ealex/stm32f334_1S_charger/hardware/stm32f334_1S_charger/stm32f334_1S_charger.pdf

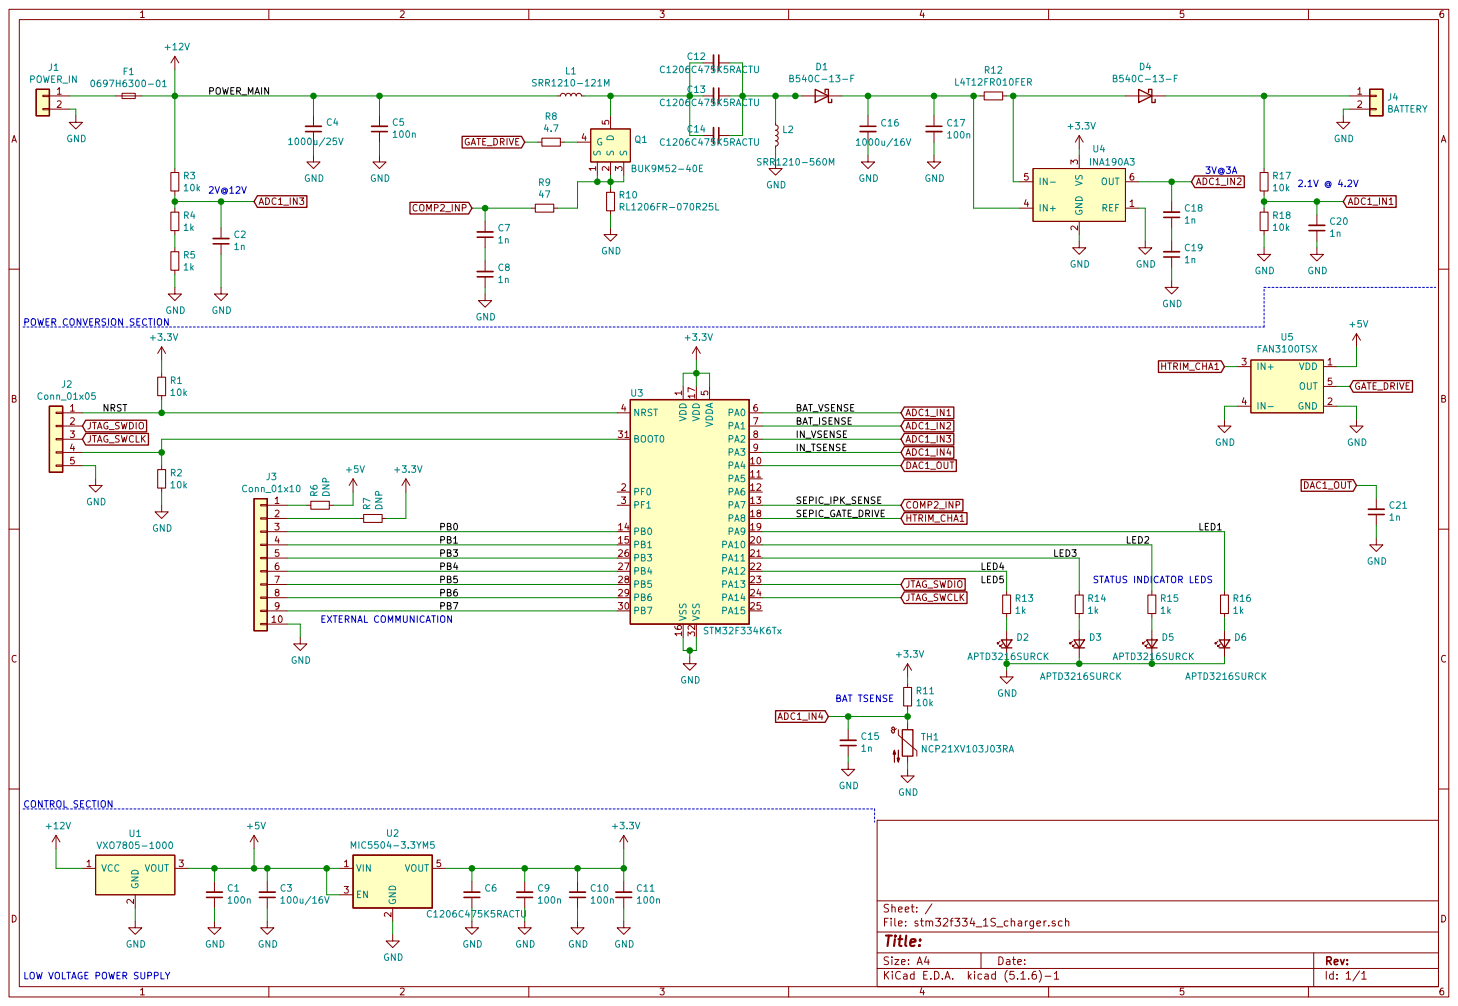
[picture p1: page 1]

4 | LED2
5 | LED3

LOW VOLTAGE POWER SUPPLY CONTROL SECTION
