ealex/stm32f334_1S_charger/hardware/stm32f334_1S_charger/stm32f334_1S_charger.kicad_pcb

## KiCad design hardware/stm32f334_1S_charger/stm32f334_1S_charger.kicad_pcb (2020-06-14)

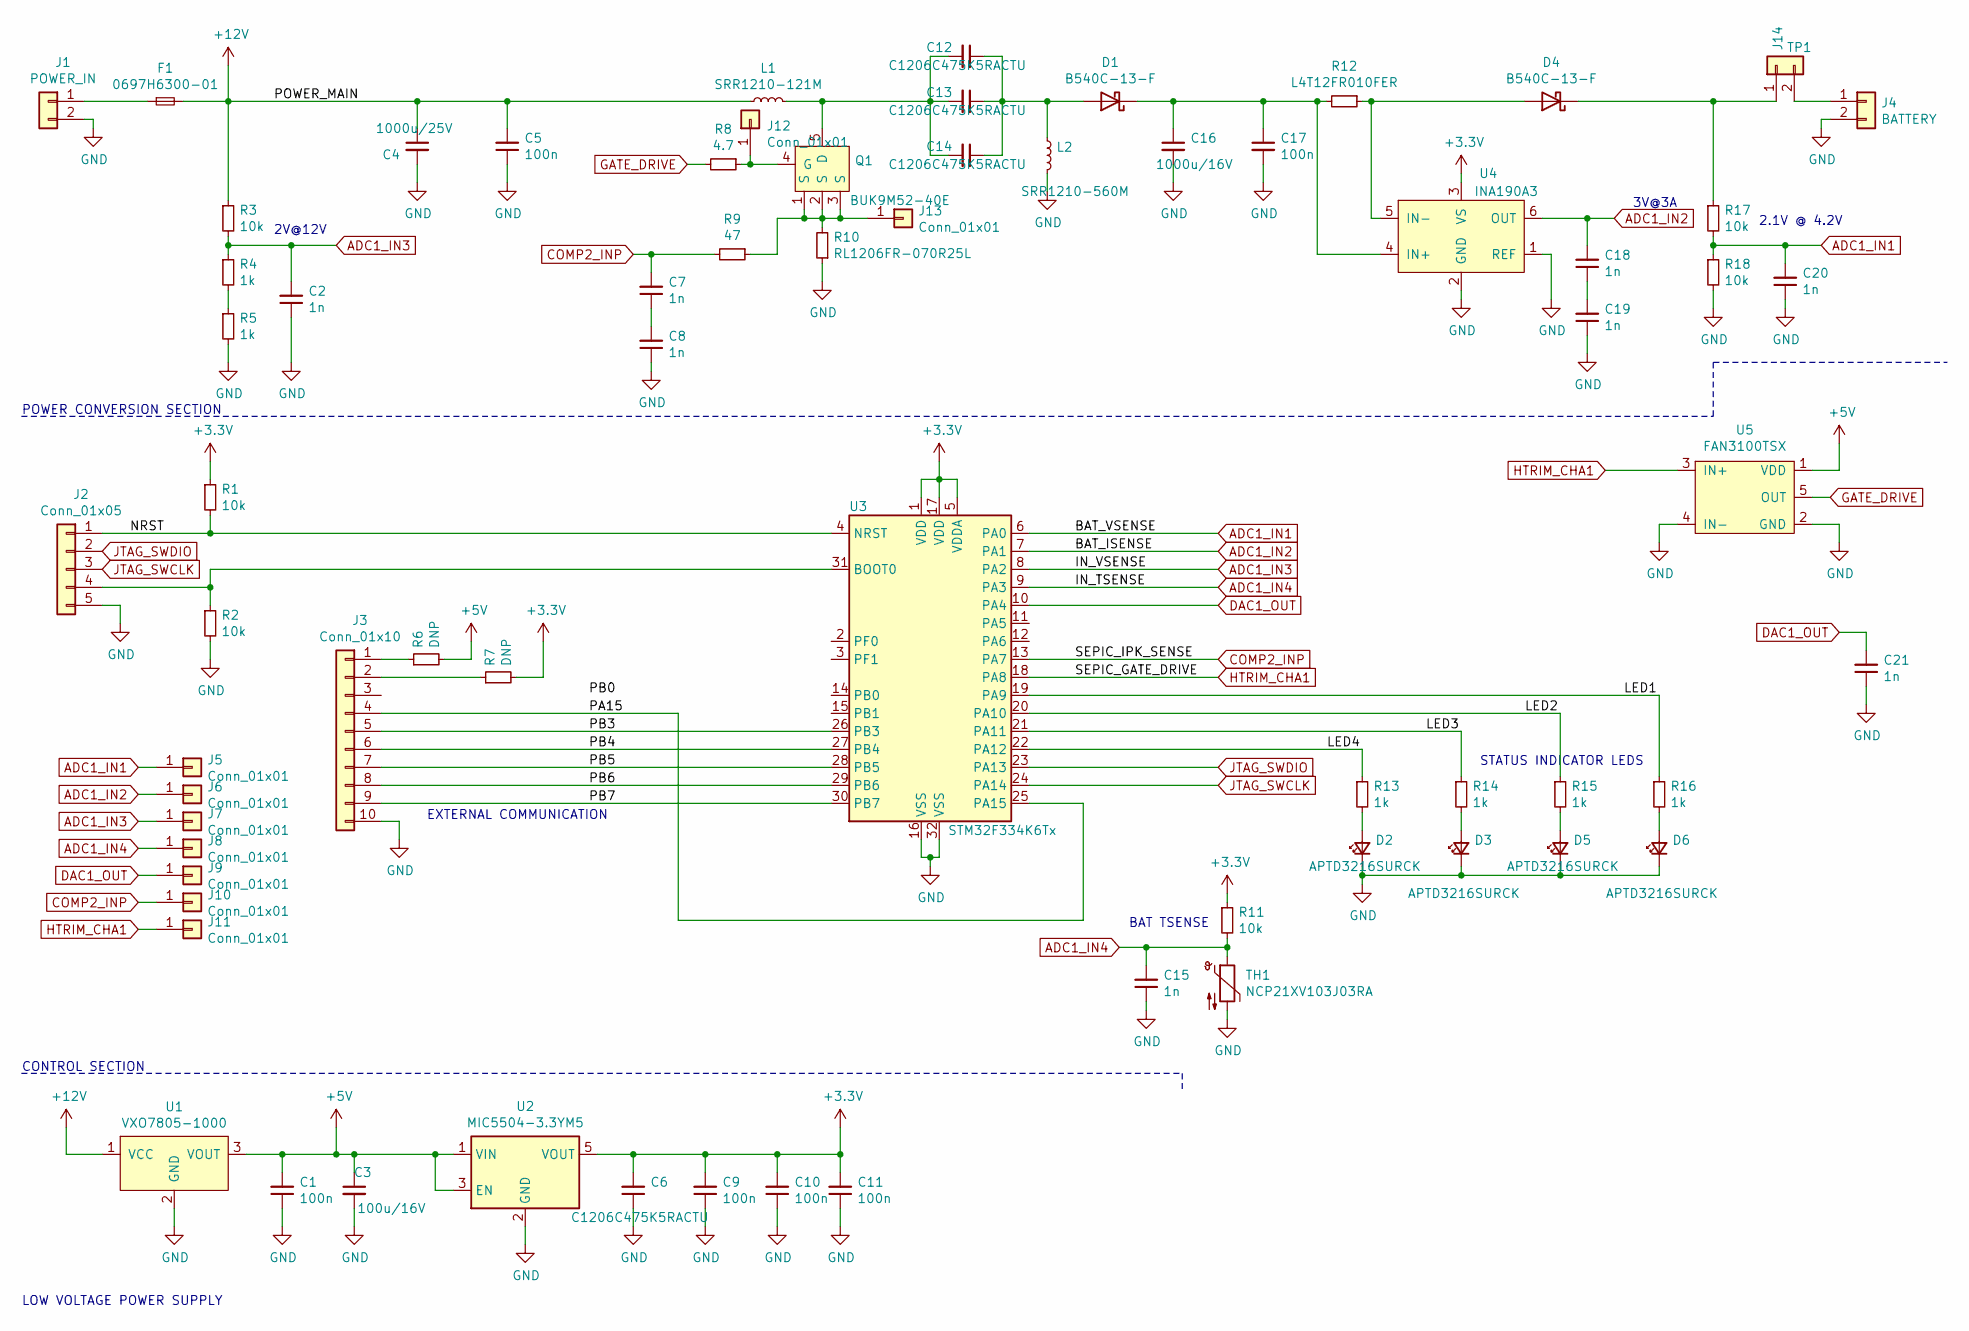
[picture p2: schematic stm32f334_1S_charger.sch]

Parts:
C1, C5, C9, C10, C11, C17: 100n; C_1206_3216Metric_Pad1.42x1.75mm_HandSolder
C2, C7, C8, C15, C18, C19, C20, C21: 1n; C_1206_3216Metric_Pad1.42x1.75mm_HandSolder
C3: 100u/16V; CP_Radial_D6.3mm_P2.50mm
C4: 1000u/25V; CP_Radial_D13.0mm_P5.00mm
C6, C12, C13, C14: C1206C475K5RACTU; C_1206_3216Metric_Pad1.42x1.75mm_HandSolder
C16: 1000u/16V; CP_Radial_D10.0mm_P5.00mm
D1, D4: B540C-13-F; D_SMC_Handsoldering
D2, D3, D5, D6: APTD3216SURCK; LED_1206_3216Metric
F1: 0697H6300-01
J1: POWER_IN; PinHeader_1x02_P2.54mm_Vertical
J2: Conn_01x05; PinHeader_1x05_P2.54mm_Vertical
J3: Conn_01x10; PinHeader_1x10_P2.54mm_Vertical
J4: BATTERY; 18650_holder
J5, J6, J7, J8, J9, J10, J11, J12, J13: Conn_01x01; PinHeader_1x01_P2.54mm_Vertical
J14: TP1; PinHeader_1x02_P2.54mm_Vertical
L1: SRR1210-121M; L_Bourns_SRR1210A
L2: SRR1210-560M; L_Bourns_SRR1210A
Q1: BUK9M52-40E; LFPAK33
R1, R2, R3, R11, R17, R18: 10k; R_1206_3216Metric_Pad1.42x1.75mm_HandSolder
R4, R5, R13, R14, R15, R16: 1k; R_1206_3216Metric_Pad1.42x1.75mm_HandSolder
R6, R7: DNP; R_1206_3216Metric_Pad1.42x1.75mm_HandSolder
R8: 4.7; R_1206_3216Metric_Pad1.42x1.75mm_HandSolder
R9: 47; R_1206_3216Metric_Pad1.42x1.75mm_HandSolder
R10: RL1206FR-070R25L; R_1206_3216Metric_Pad1.42x1.75mm_HandSolder
R12: L4T12FR010FER; R_1206_3216Metric_Pad1.42x1.75mm_HandSolder
TH1: NCP21XV103J03RA; R_0805_2012Metric_Pad1.15x1.40mm_HandSolder
U1: VXO7805-1000
U2: MIC5504-3.3YM5; SOT-23-5
U3: STM32F334K6Tx; LQFP-32_7x7mm_P0.8mm
U4: INA190A3; SC70-6
U5: FAN3100TSX; SOT-23-5_HandSoldering

Connections:
+3V3: C6.2, C9.2, C10.2, C11.2, R1.1, R7.2, R11.1, U2.5 (VOUT), U3.1 (VDD), U3.5 (VDDA), U3.17 (VDD), U4.3 (VS)
+5V: C1.2, C3.1, R6.2, U1.3 (VOUT), U2.1 (VIN), U2.3 (EN), U5.1 (VDD)
+12V: C4.1, C5.2, F1.2, L1.1, R3.1, U1.1 (VCC)
/LED1: R16.1, U3.19 (PA9)
/LED2: R15.1, U3.20 (PA10)
/LED3: R14.1, U3.21 (PA11)
/LED4: R13.1, U3.22 (PA12)
/NRST: J2.1, R1.2, U3.4 (NRST)
/PA15: J3.4, U3.25 (PA15)
/PB3: J3.5, U3.26 (PB3)
/PB4: J3.6, U3.27 (PB4)
/PB5: J3.7, U3.28 (PB5)
/PB6: J3.8, U3.29 (PB6)
/PB7: J3.9, U3.30 (PB7)
ADC1_IN1: C20.2, J5.1, R17.2, R18.1, U3.6 (PA0)
ADC1_IN2: C18.2, J6.1, U3.7 (PA1), U4.6 (OUT)
ADC1_IN3: C2.2, J7.1, R3.2, R4.1, U3.8 (PA2)
ADC1_IN4: C15.2, J8.1, R11.2, TH1.1, U3.9 (PA3)
COMP2_INP: C7.2, J10.1, R9.2, U3.13 (PA7)
DAC1_OUT: C21.2, J9.1, U3.10 (PA4)
GATE_DRIVE: R8.2, U5.5 (OUT)
GND: C1.1, C2.1, C3.2, C4.2, C5.1, C6.1, C8.1, C9.1, C10.1, C11.1, C15.1, C16.2, C17.2, C19.1, C20.1, C21.1, D2.1 (K), D3.1 (K), D5.1 (K), D6.1 (K), J1.2, J2.5, J3.10, J4.2, L2.2, R2.2, R5.2, R10.1, R18.2, TH1.2, U1.2 (GND), U2.2 (GND), U3.16 (VSS), U3.32 (VSS), U4.1 (REF), U4.2 (GND), U5.2 (GND), U5.4 (IN-)
HTRIM_CHA1: J11.1, U3.18 (PA8), U5.3 (IN+)
JTAG_SWCLK: J2.3, U3.24 (PA14)
JTAG_SWDIO: J2.2, U3.23 (PA13)
unnamed: C7.1, C8.2
unnamed: C12.1, C13.1, C14.1, D1.2 (A), L2.1
unnamed: C12.2, C13.2, C14.2, L1.2, Q1.5 (D)
unnamed: C16.1, C17.1, D1.1 (K), R12.2, U4.4 (IN+)
unnamed: C18.1, C19.2
unnamed: D2.2 (A), R13.2
unnamed: D3.2 (A), R14.2
unnamed: D4.1 (K), J14.1, R17.1
unnamed: D4.2 (A), R12.1, U4.5 (IN-)
unnamed: D5.2 (A), R15.2
unnamed: D6.2 (A), R16.2
unnamed: F1.1, J1.1
unnamed: J2.4, R2.1, U3.31 (BOOT0)
unnamed: J3.1, R6.1
unnamed: J3.2, R7.1
unnamed: J12.1, Q1.4 (G), R8.1
unnamed: J13.1, Q1.1 (S), Q1.2 (S), Q1.3 (S), R9.1, R10.2
unnamed: J4.1, J14.2
unnamed: R4.2, R5.1

Notes on the sheet:
2V@12V
2.1V @ 4.2V
3V@3A
POWER CONVERSION SECTION
LOW VOLTAGE POWER SUPPLY
CONTROL SECTION
STATUS INDICATOR LEDS
EXTERNAL COMMUNICATION
BAT TSENSE

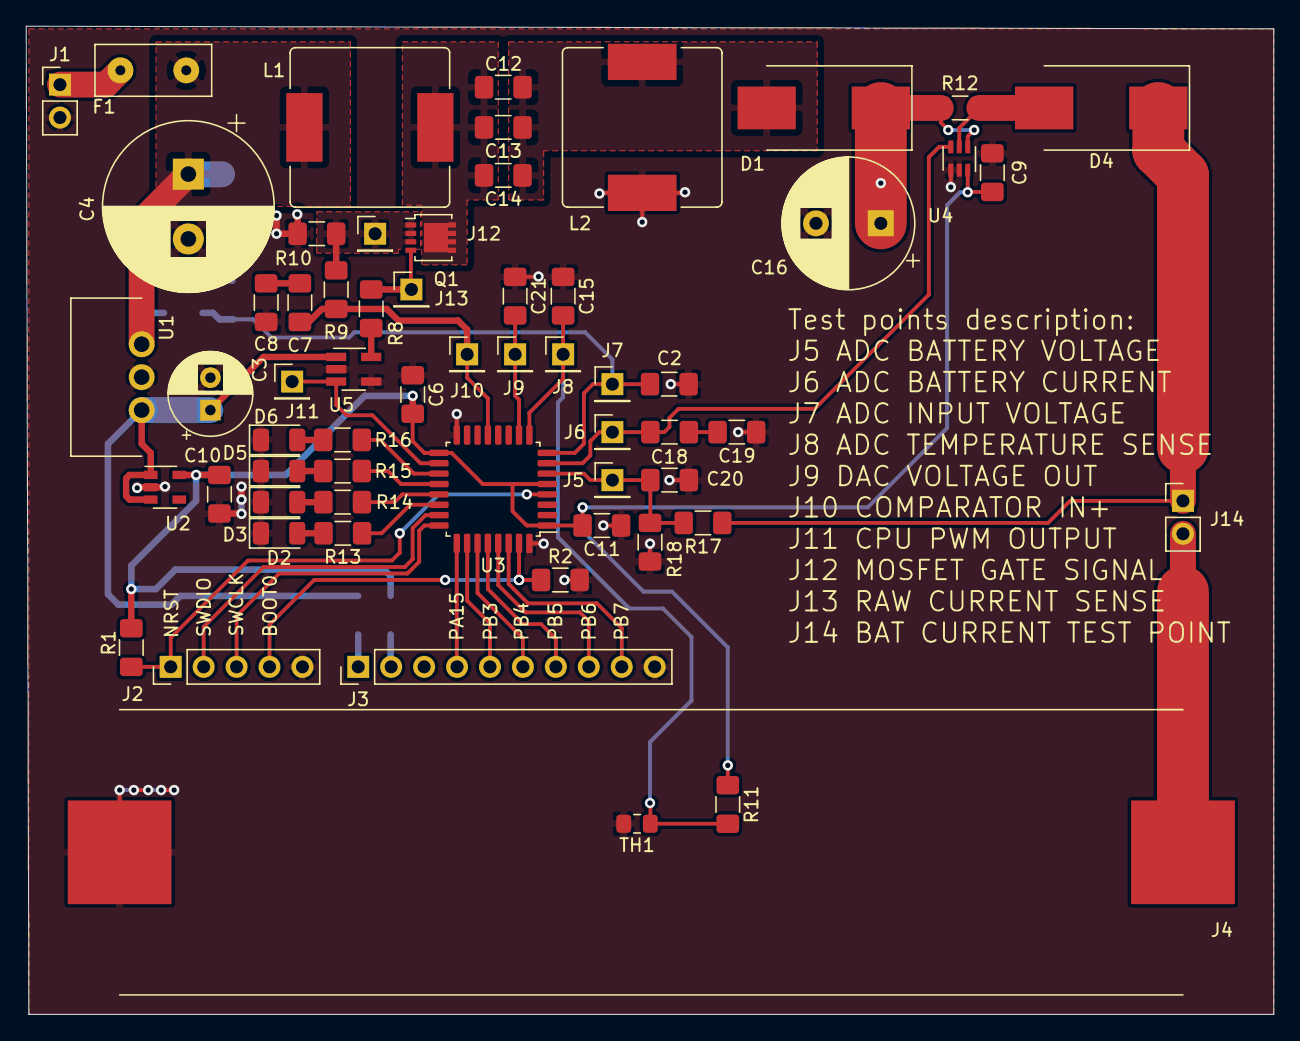
[picture p3: board stm32f334_1S_charger.kicad_pcb from above]

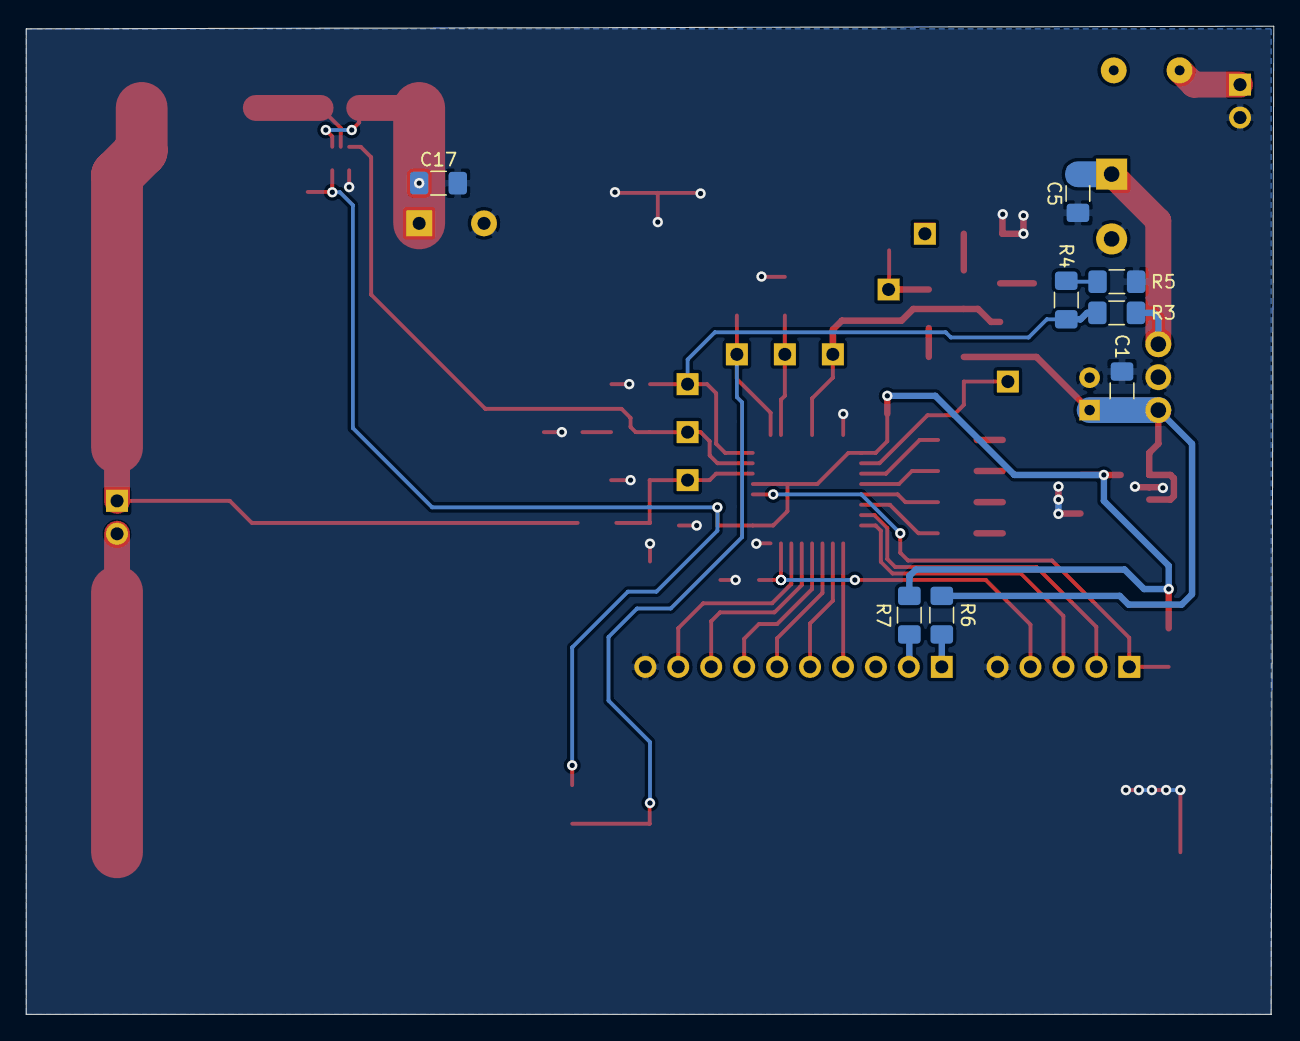
[picture p4: board stm32f334_1S_charger.kicad_pcb from below]

Board: 2 copper layers, 96.2 x 76.2 mm, 69 parts (8 on the bottom side), 44 nets.
