ealex/stm32f334_1S_charger/software/stm32f334_1S_charger.ioc

Mcu.UserName=STM32F334K6Tx
PA0.Signal=ADC1_IN1
PA1.Signal=ADC1_IN2
PA10.GPIO_Label=LED2
PA10.Signal=GPIO_Output
PA11.GPIO_Label=LED3
PA11.Signal=GPIO_Output
PA12.GPIO_Label=LED4
PA12.Signal=GPIO_Output
PA13.Signal=SYS_JTMS-SWDIO
PA14.Signal=SYS_JTCK-SWCLK
PA2.Signal=ADC1_IN3
PA3.Signal=ADC1_IN4
PA4.Signal=SharedAnalog_PA4
PA7.Signal=COMP2_INP
PA8.Signal=HRTIM1_CHA1
PA9.GPIO_Label=LED1
PA9.Signal=GPIO_Output
