ealex/stm32f334_1S_charger/software/Core/Inc/main.h

#define LED1_Pin GPIO_PIN_9
#define LED1_GPIO_Port GPIOA
#define LED2_Pin GPIO_PIN_10
#define LED2_GPIO_Port GPIOA
#define LED3_Pin GPIO_PIN_11
#define LED3_GPIO_Port GPIOA
#define LED4_Pin GPIO_PIN_12
#define LED4_GPIO_Port GPIOA
