ealex/stm32f334_1S_charger/(commit log)

2020-05-24 add docs and schematic
    [stm32f334_1S_charger.kicad_pcb, stm32f334_1S_charger.sch]
2020-05-26 schematic revision 1 - all parts and footprint + software frame-work
    [stm32f334_1S_charger.sch]
2020-05-27 v1.0 board, pre-production
    [stm32f334_1S_charger.sch]
2020-05-28 v 1.0 board, pre-production
    [stm32f334_1S_charger.kicad_pcb]
2020-06-14 add bom
    [stm32f334_1S_charger-B_Cu.gbr, stm32f334_1S_charger-B_Mask.gbr, stm32f334_1S_charger-B_SilkS.gbr, stm32f334_1S_charger-Edge_Cuts.gbr, stm32f334_1S_charger-F_Cu.gbr, stm32f334_1S_charger-F_Mask.gbr, stm32f334_1S_charger-F_SilkS.gbr, stm32f334_1S_charger-Margin.gbr]
